elisavg5/feedback-box-project/Fiches TUTO/Fiche TUTO - Récepteur Arduino.pdf

### Mettre en place un récepteur LoRa avec un Arduino MKR WAN

1310

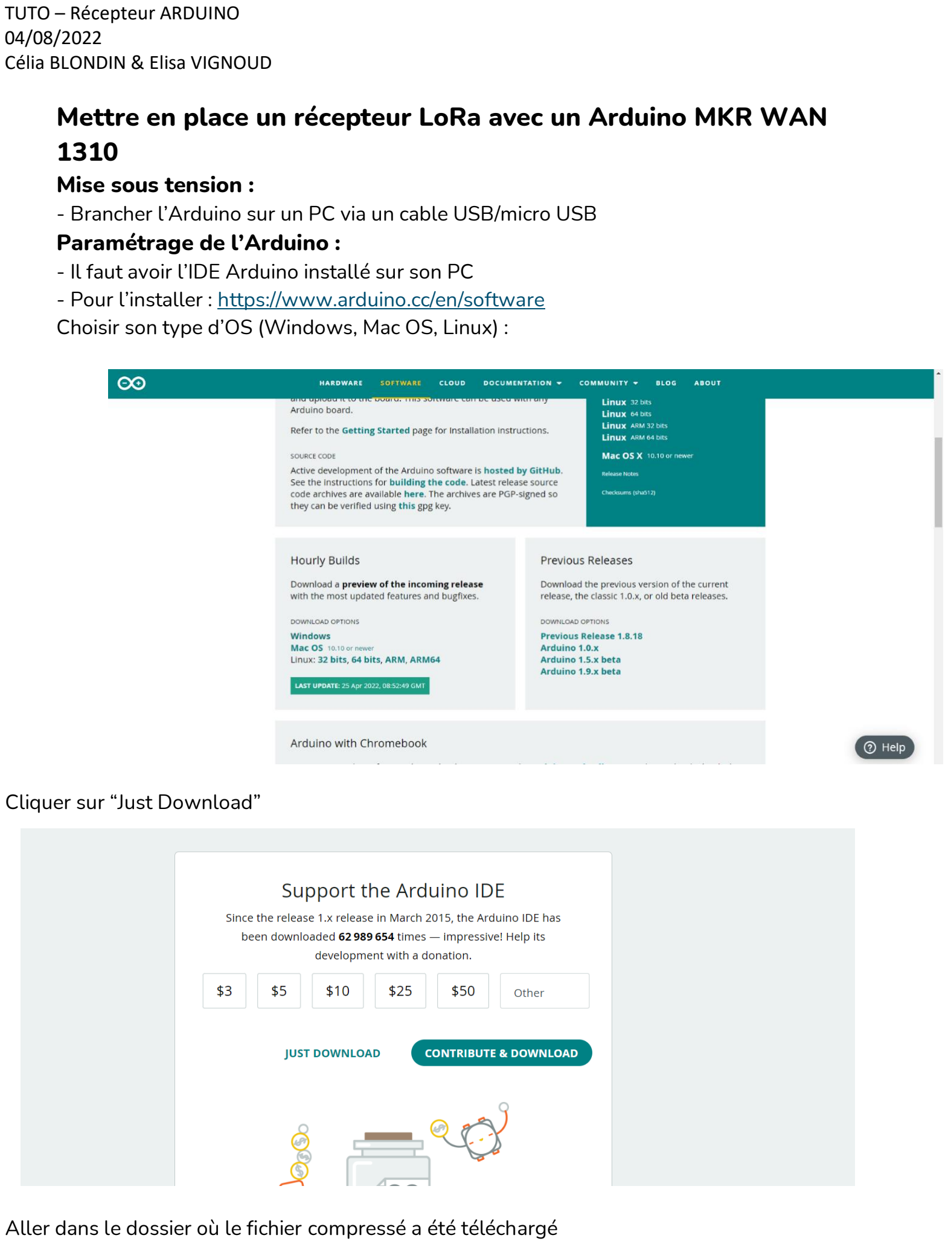
[picture p10: page 1]

TUTO – Récepteur ARDUINO

Célia BLONDIN & Elisa VIGNOUD

Mise sous tension :
- Brancher l’Arduino sur un PC via un cable USB/micro USB Paramétrage de l’Arduino :
- Il faut avoir l’IDE Arduino installé sur son PC
- Pour l’installer : https://www.arduino.cc/en/software Choisir son type d’OS (Windows, Mac OS, Linux) :

Cliquer sur “Just Download”

Aller dans le dossier où le fichier compressé a été téléchargé

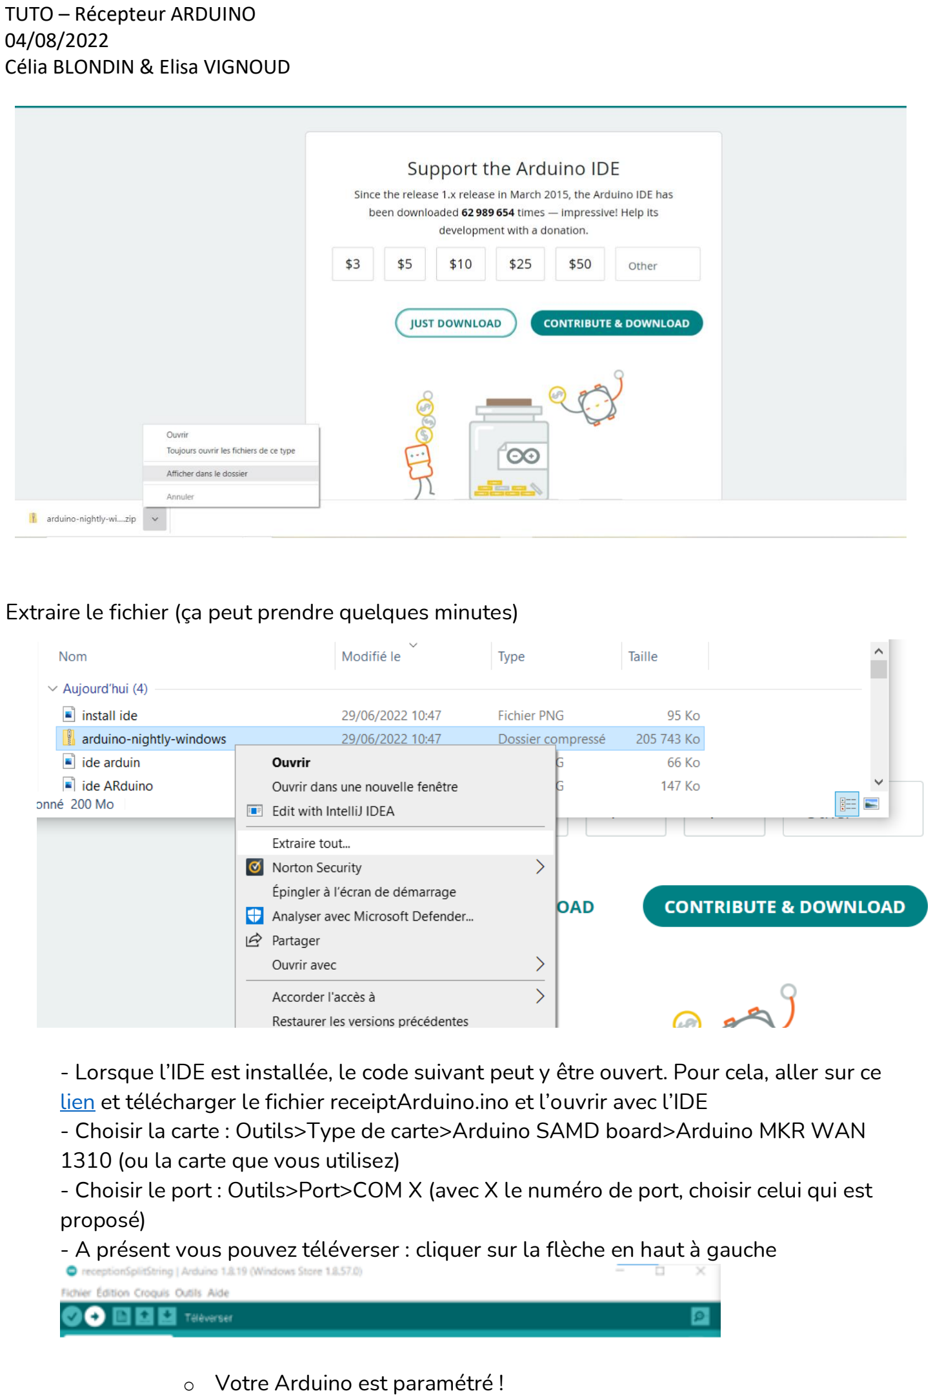
[picture p11: page 2]

Célia BLONDIN & Elisa VIGNOUD

Extraire le fichier (ça peut prendre quelques minutes)

- Lorsque l’IDE est installée, le code suivant peut y être ouvert. Pour cela, aller sur ce lien (https://github.com/elisavg5/feedback-box-project/tree/arduino_receipt/receptArduino) et télécharger le fichier receiptArduino.ino et l’ouvrir avec l’IDE
- Choisir la carte : Outils>Type de carte>Arduino SAMD board>Arduino MKR WAN 1310 (ou la carte que vous utilisez)
- Choisir le port : Outils>Port>COM X (avec X le numéro de port, choisir celui qui est proposé)
- A présent vous pouvez téléverser : cliquer sur la flèche en haut à gauche
- Votre Arduino est paramétré !

Célia BLONDIN & Elisa VIGNOUD
Recevoir les données et les interpréter :
Pour vérifier si l’on reçoit bien les données, on peut regarder le moniteur série de l’IDE, pour cela il faut cliquer sur la petite loupe en haut à droite.
Pour recevoir les données dans un excel microsoft (de la suite Office), nous avons utilisé un outil qui s’appelle DataStreamer c’est une extension à télécharger.
- Pour le télécharger : https://www.microsoft.com/enus/download/details.aspx?id=56976 (https://www.microsoft.com/en-us/download/details.aspx?id=56976)
- Cliquer sur Download
- De la même manière que pour l’IDE il faut aller dans l’emplacement où le fichier a été téléchargé, extraire le zip.
- Une fois le dossier sous sa forme non zippée, il faut aller dans le dossier Data Streamer_4_0_0_0 et double cliquer sur setup et suivre les instructions d’installation, s’il y en a.

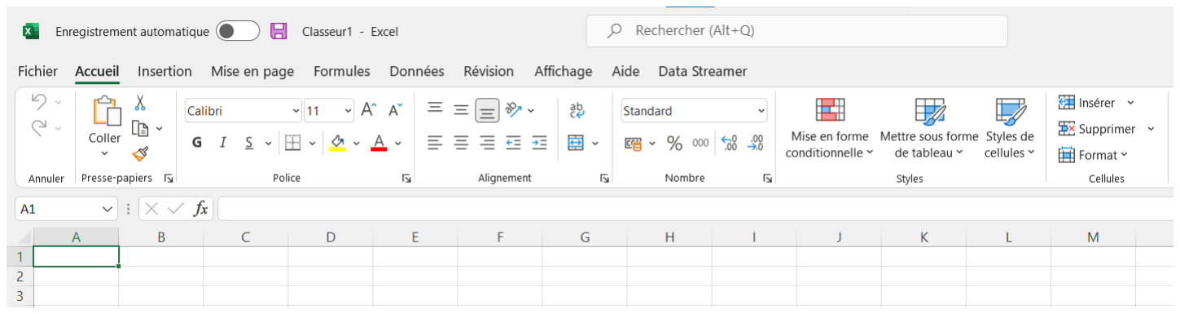
[picture p12: figure]

A présent, l’extension apparait sur votre excel.

Célia BLONDIN & Elisa VIGNOUD

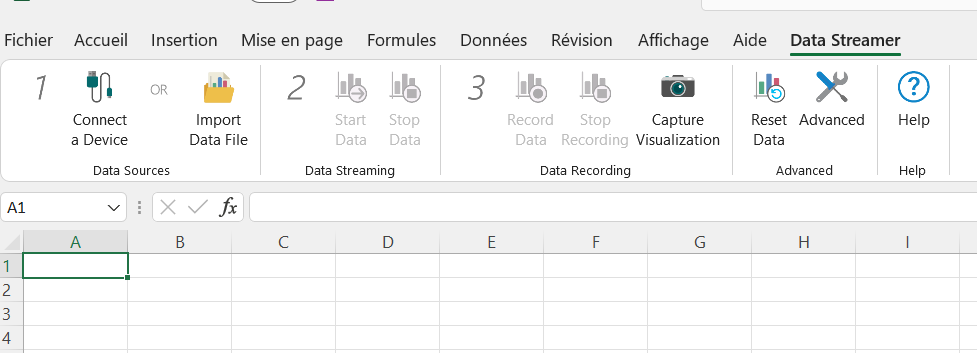
[picture p13: figure]

Il est maintenant indiqué que l’on peut connecter un équipement, si votre Arduino est connecté à votre PC, l’Excel va vous proposer de se connecter automatiquement à celui-ci

- Dans le cadre de notre récepteur, nous utilisons l’excel qui est disponible à l’adresse : https://github.com/elisavg5/feedback-boxproject/tree/arduino_receipt (https://github.com/elisavg5/feedback-box-project/tree/arduino_receipt/receptArduino) et il faut récupérer l’excel nommé RécupérationExcelArduino.xlsx qui nous permet d’avoir une vision sur nos données en direct.
