elisavg5/feedback-box-project/Fiches TUTO/Fiche TUTO - Récepteur Raspberry.pdf

TUTO – Récepteur Raspberry

Célia BLONDIN & Elisa VIGNOUD
Formater la Raspberry / Mise en place de l’OS
1) Installer Raspberry Pi Imager sur un PC https://www.raspberrypi.com/software/
2) Récupérer une carte SD
3) Insérer la carte SD dans le port SD d’un PC
4) Ouvrir le logiciel Raspberry Pi Imager
5) Choisir comme système d’exploitation celui proposé : Raspberry Pi OS – 32 Bit
6) Sélectionner la carte SD
7) Cliquer sur écrire

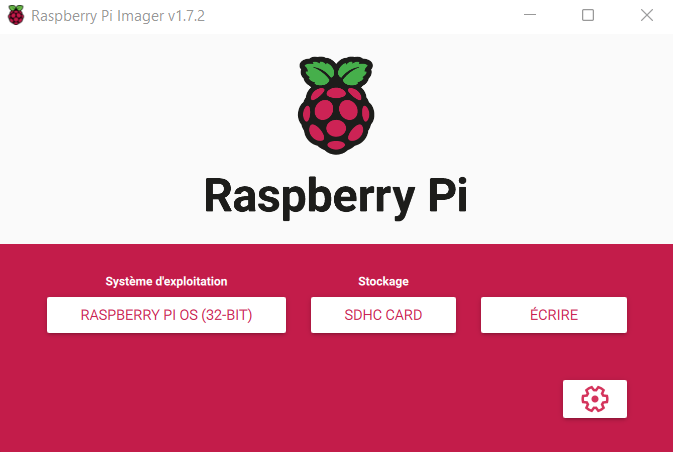
[picture p14: figure]

8) Cliquer sur Oui

Célia BLONDIN & Elisa VIGNOUD

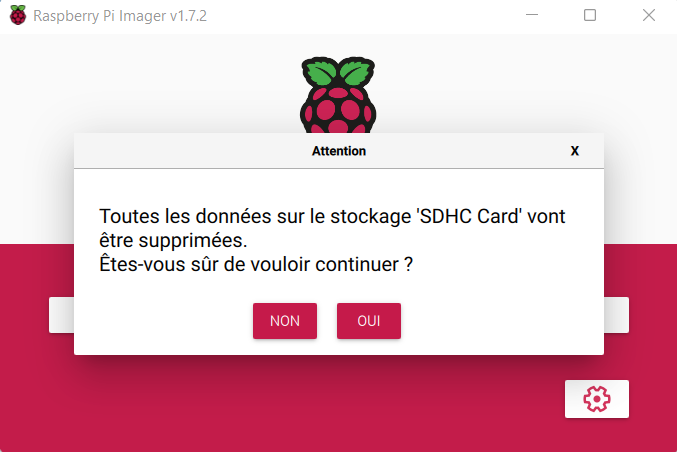
[picture p15: figure]

9) Attendre que ce soit formaté
10)Ejecter la carte SD proprement
11)Insérer la carte SD dans le port SD de la Raspberry. Sens : côté avec du métal vers le haut
Premier démarrage de la Raspberry
1) Brancher un écran à la Raspberry via le port HDMI
2) Brancher une souris et un clavier sur les ports USB de la Raspberry Vous pouvez brancher un câble ethernet si vous en avez
3) Alimenter la Raspberry avec un câble micro-usb B
4) Appuyer sur Next

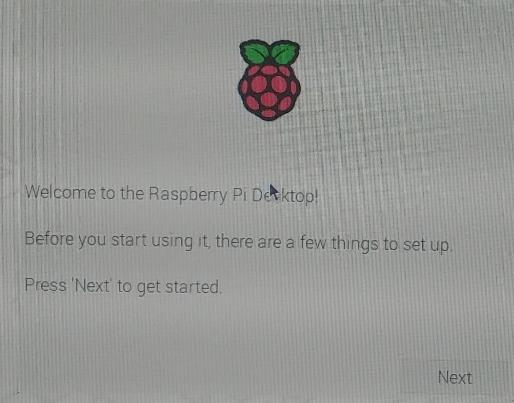
[picture p16: figure]

5) Sélectionner le pays et la langue

Célia BLONDIN & Elisa VIGNOUD

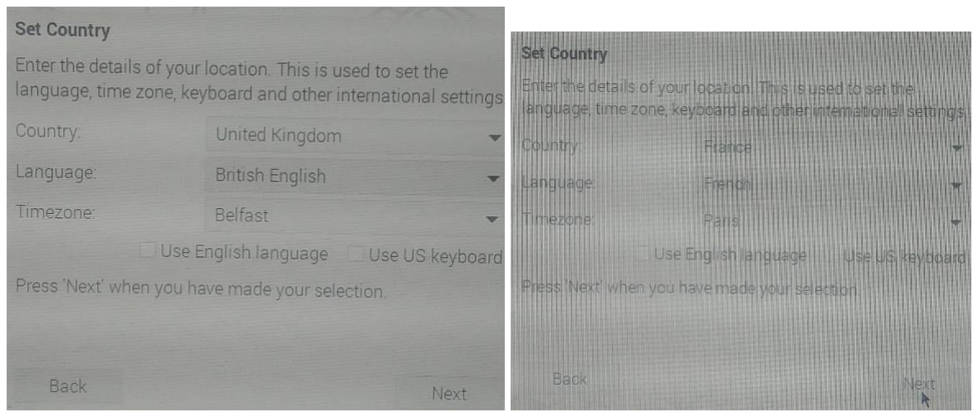
[picture p17: figure]

6) Configurer un nom d’utilisateur et un mot de passe (Id : hi-raspberry ; mdp : hi-raspberry)

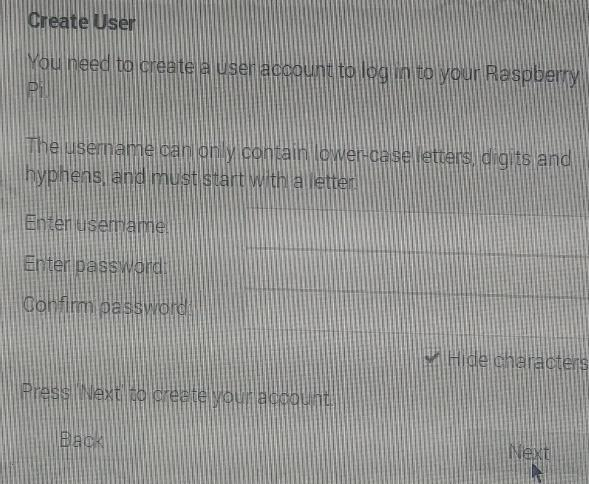
[picture p18: figure]

7) Configurer un wifi si besoin (si pas de câble ethernet/la configuration peut se faire après aussi)

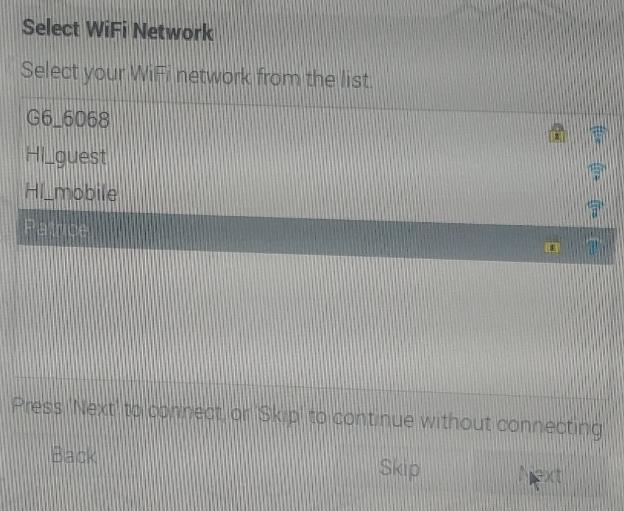
[picture p19: figure]

8) Ensuite appuyer sur next jusqu’à la fin
9) Restart Raspberry
Configurer le récepteur partie Serveur

Célia BLONDIN & Elisa VIGNOUD
Pour la partie récepteur, on utilise un principe client-serveur. On va d’abord configurer le serveur qui permet d’envoyer les données issues du client vers la BDD.
Pour ces commandes il va falloir passer par le terminal de commande, c’est l’icône noir en haut à gauche de l’écran d’accueil de la Raspberry
1) Installation de la commande git
(sudo est une commande afin d’effectuer les commandes suivantes en roots = avec les droits administrateurs)
sudo apt-get install git
sudo raspi-config

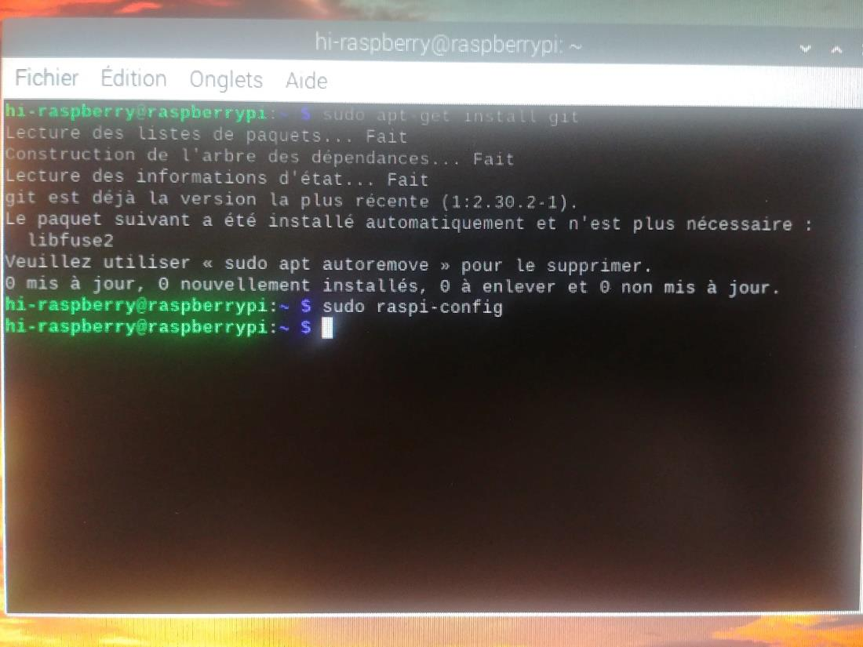
[picture p20: figure]

2) Activer SPI sur le Raspberry Pi : naviguer avec les flèches du clavier Choisir Interface Option, puis SPI, il faut l’autoriser (enable : yes), valider avec OK

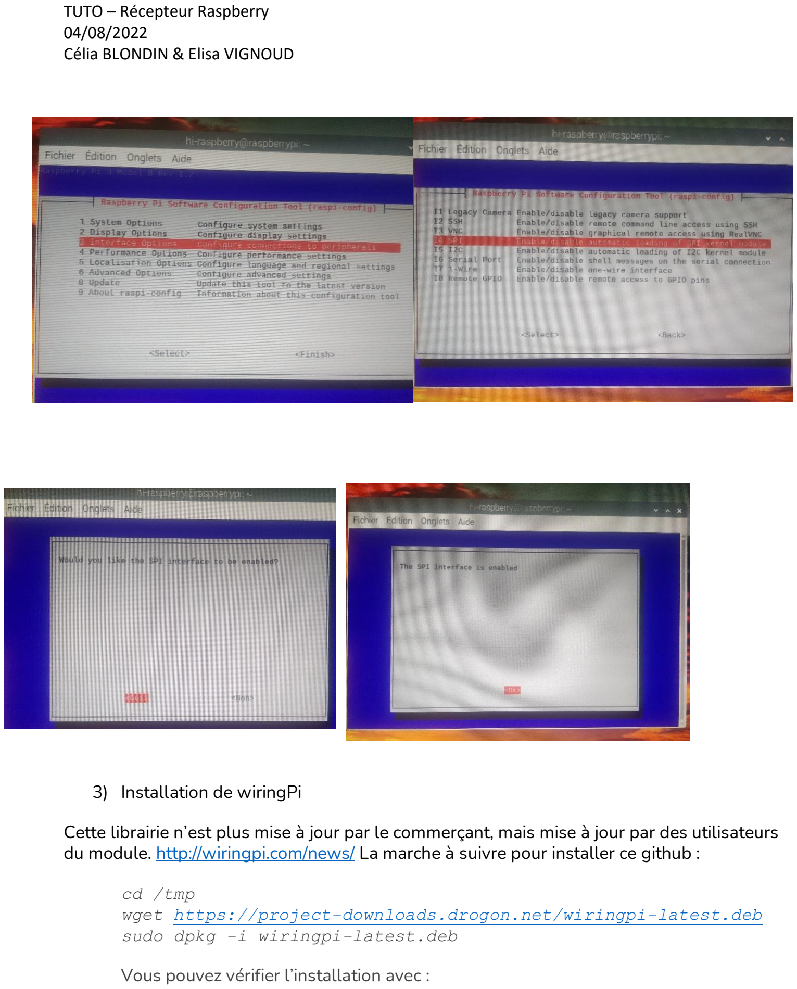
[picture p21: page 5]

Célia BLONDIN & Elisa VIGNOUD

3) Installation de wiringPi
Cette librairie n’est plus mise à jour par le commerçant, mais mise à jour par des utilisateurs du module. http://wiringpi.com/news/ La marche à suivre pour installer ce github :

cd /tmp
wget https://project-downloads.drogon.net/wiringpi-latest.deb sudo dpkg -i wiringpi-latest.deb
Vous pouvez vérifier l’installation avec :

Célia BLONDIN & Elisa VIGNOUD
gpio –v

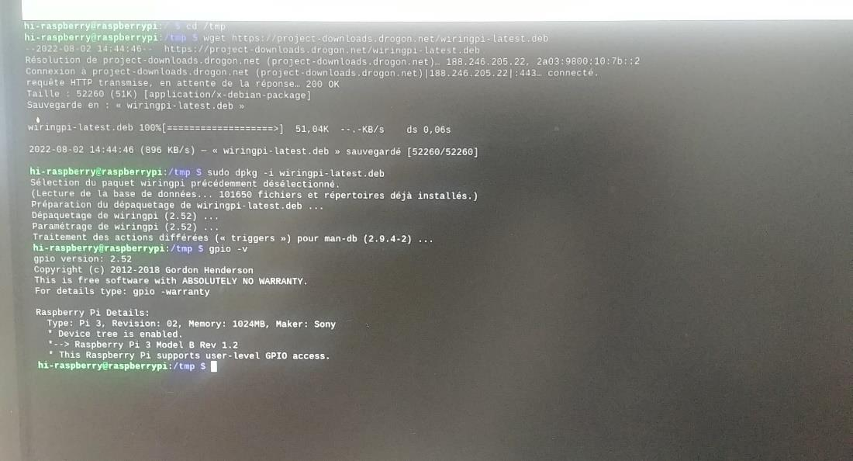
[picture p22: figure]

4) Il faut à présent télécharger le code Lora issu de Github afin de créer un client qui reçoit les données LoRa et les envoie au serveur Python
a. On va dans le dossier qui nous intéresse (ici hi-raspberry est notre nom d’utilisateur de la raspberry, il faut mettre votre nom d’utilisateur s’il est différent)
cd ../home/hi-raspberry/Documents
b. On récupère les dossiers présents sur notre Github
wget https://codeload.github.com/elisavg5/feedback-box-project/zip/raspb_receipt
c. On décompresse le dossier

Célia BLONDIN & Elisa VIGNOUD
unzip raspb_receipt

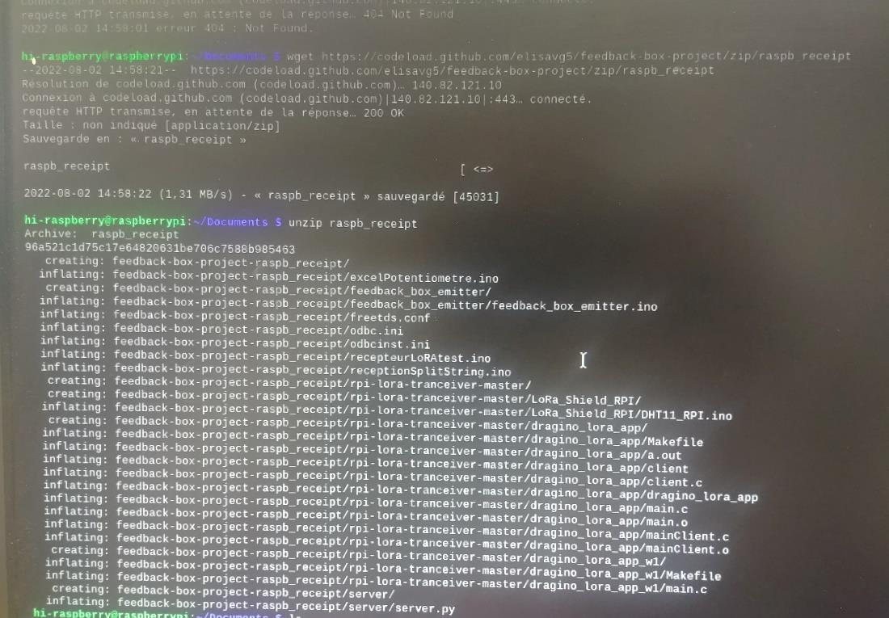
[picture p23: figure]

5) On télécharge les librairies UnixODBC et freeTDS et toutes les autres qui permettent le lien avec le BDD
sudo apt-get install unixodbc unixodbc-dev freetds-dev freetds-bin tdsodbc
6) Configuration fichiers ODBC
a. On se rend dans le bon dossier
cd /../..
b. On bouge les documents odbcinst.ini et odbc.ini dans le dossier /etc/ sudo mv /home/hi-raspberry/Documents/feedback-box-serverraspb_receipt/odbcinst.ini /etc/
sudo mv /home/hi-raspberry/Documents/feedback-box-serverraspb_receipt/odbc.ini /etc/
7) On installe la librairie pyodbc
pip install pyodbc
8) On se place dans le bon dossier issu du Github que l’on a déjà récupéré cd
cd Documents/feedback-box-server-raspb_receipt/server
9) On exécute le serveur

Célia BLONDIN & Elisa VIGNOUD
python3 server.py

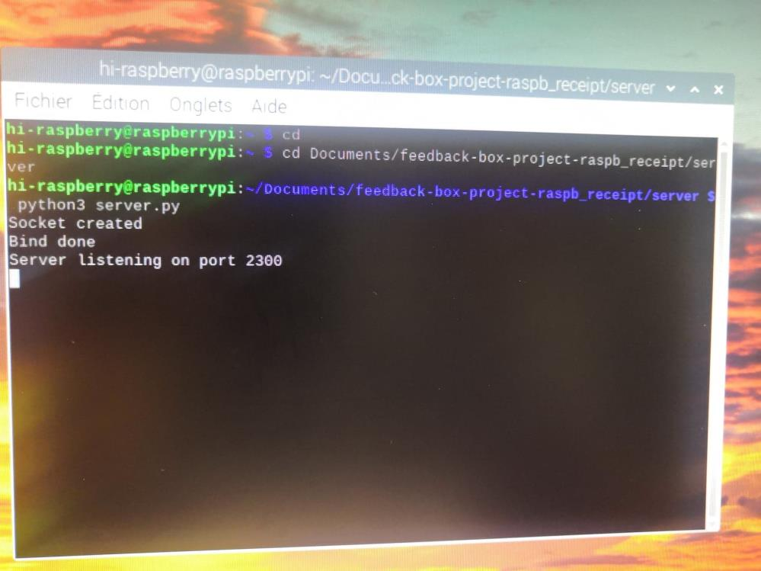
[picture p24: figure]

Configurer le récepteur Client

A présent, nous allons configurer le code client qui permet de recevoir les données LoRa.
a. On va dans le bon emplacement de notre dossier Github déjà téléchargé
cd
cd Documents/feedback-box-project-raspb_receipt/rpi-lora-tranceivermaster/dragino_lora_app
b. On active les droits d’exécution sur le fichier que l’on veut exécuter chmod +x dragino_lora_app
c. On le compile
make
d. On exécute le code client

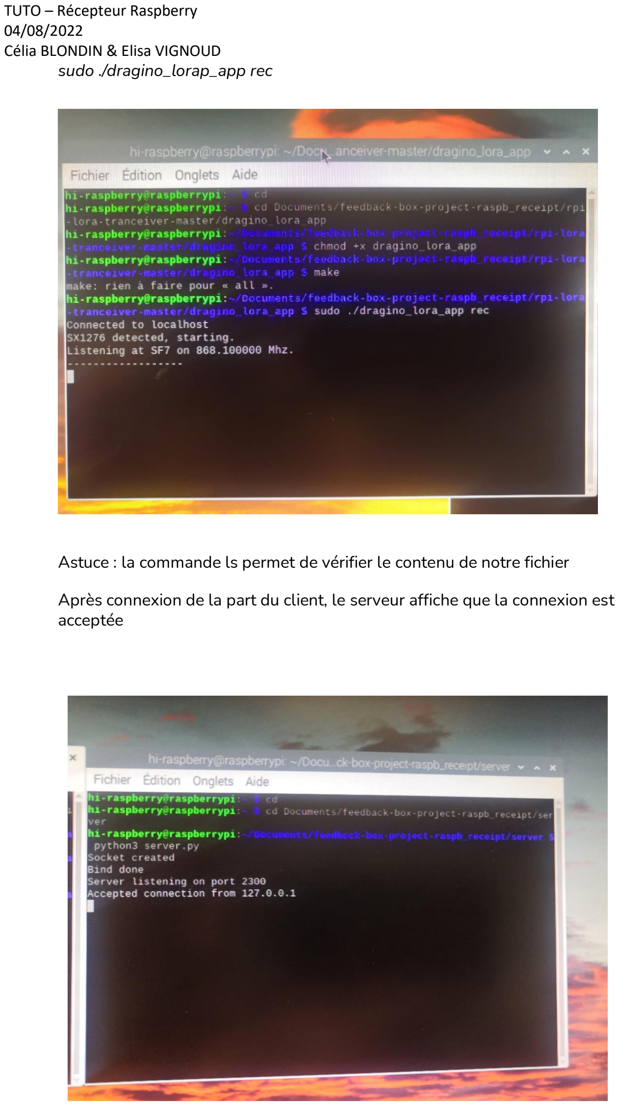
[picture p25: page 9]

Célia BLONDIN & Elisa VIGNOUD
sudo ./dragino_lorap_app rec

Astuce : la commande ls permet de vérifier le contenu de notre fichier Après connexion de la part du client, le serveur affiche que la connexion est acceptée

Célia BLONDIN & Elisa VIGNOUD
Après réception d’un paquet de données :

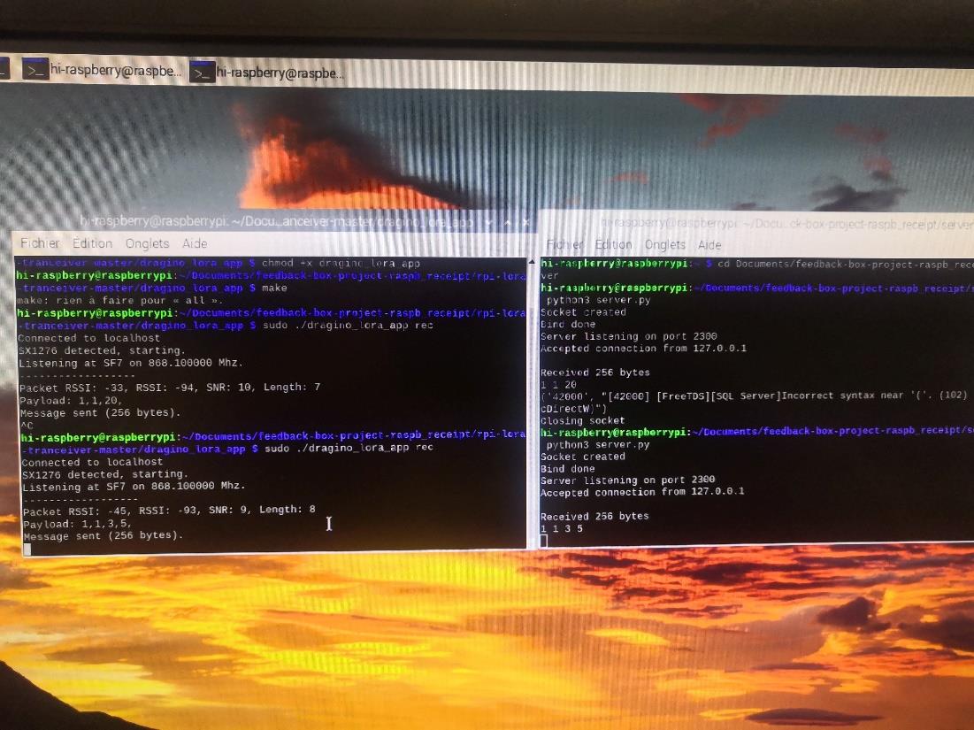
[picture p26: figure]
