elisavg5/feedback-box-project/Fiches TUTO/Fiche TUTO - Se connecter à la BDD.pdf

TUTO – Se Connecter à la BDD Azure

Célia BLONDIN & Elisa VIGNOUD

### Se connecter à la base de données

Un logiciel qui permet d’avoir une vision pratique et une connexion facile à la base de données est Azure Data Studio.

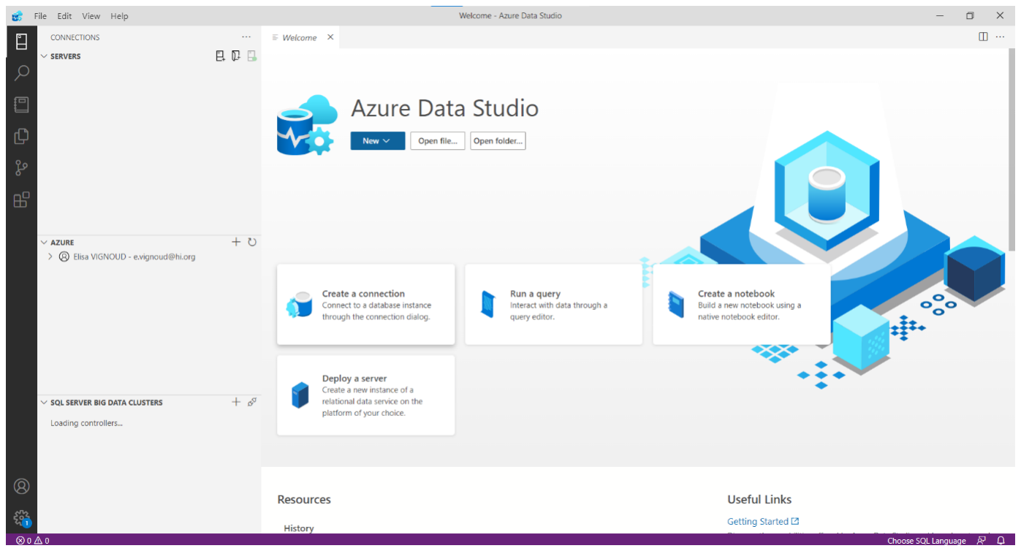
[picture p27: figure]

1 – cliquer sur create a connection

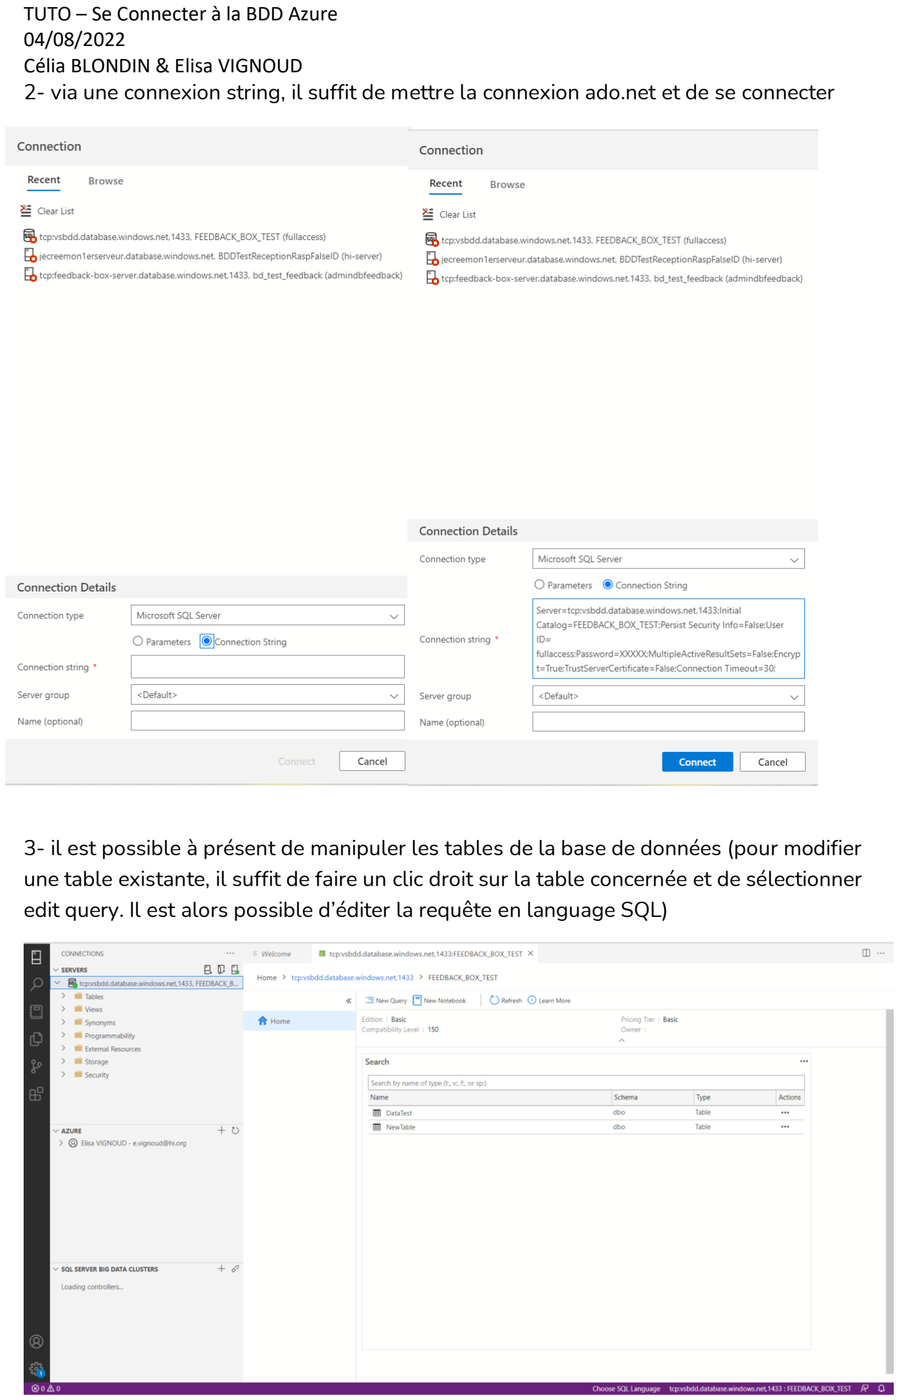
[picture p28: page 2]

Célia BLONDIN & Elisa VIGNOUD
2- via une connexion string, il suffit de mettre la connexion ado.net et de se connecter

3- il est possible à présent de manipuler les tables de la base de données (pour modifier une table existante, il suffit de faire un clic droit sur la table concernée et de sélectionner edit query. Il est alors possible d’éditer la requête en language SQL)

Célia BLONDIN & Elisa VIGNOUD
