elisavg5/feedback-box-project/(commit log)

2022-05-30 Create feedback_box_emitter.ino
    Feedback box emitter :
    - buttons work
    - debounce buttons is effective (?)
    - sending LoRa data
    - packet : "question,bouton,seq!"
    - storing on SD File
2022-05-30 Working leds + buttons
    +Add a file for arduino (wants that the arduino file is in a file with the same name)
    + working leds with the buttons
    - not clean have to clean that a bit
2022-05-30 nicer led on
    Optimizing the ledOn function
2022-05-30 recepteur work
    il y a le lien potentiomètre excel
    il y a la reception classique
    et l'essai de split
2022-05-31 Correction bug led D4
    Led D4 was always turn on bc the D4 was the pin used for the SD module too -> modification D4 to D6
    [feedback_box_emitter.ino]
2022-08-01 RASPBERRY FILES
    conf odbc/odbcinst/freetds
    server push db azure
    client lora reception
